mzotof/KR_MPS/README.md

**Курсовая работа по МПС "Электронная очередь"**

master.c - главный мастер

slave_user.c - прием сигналов от пользователей о прохождении

slave_admin.c - прием сигналов от админа о вызове пользователя
