mzotof/KR_MPS/РПЗ.pdf

Реферат

Расчетно-пояснительная записка страниц 33, рисунков 17, таблиц 5, ис-

точников 10, приложений 4.

Ключевые слова: МИКРОКОНТРОЛЛЕР, ATMEGA32, ЭЛЕКТРОННАЯ

ОЧЕРЕДЬ, СЕТЬ, RS-485, АППАРАТАНАЯ СИСТЕМА.

Объектом разработки данной курсовой работы является проект аппарат-

ная система «Электронная очередь», предназначенная для организации элек-

тронной очереди, в которой участвуют пользователи, администраторы и

устройства, отображающие состояние очереди.

Целью разработки являлось проектирование функционально законченной

системы, построенной на микроконтроллерах, удовлетворяющей заданным

техническим заданием требованиям, и разработка необходимой конструктор-

ской и технической документации на проектируемую систему. При проектиро-

вании были решены следующие задачи: анализ объекта разработки на функци-

ональном уровне, разработка функциональной схемы системы, выбор элемент-

ной базы для реализации объекта, расчет электрических параметров.

В ходе работы разработаны алгоритмы функционирования системы,

функциональная и электрическая принципиальная схемы, написаны коды

функционирования, соответствующие разработанным алгоритмам.

Для написания кодов был использован язык СИ AVR, работа осуществ-

лялась в среде WinAVR. Для проверки работоспособности разработанная схема

была промоделирована в среде Proteus ISIS 8.

Результатом проектирования является комплект конструкторской доку-

ментации для изготовления аппаратной системы «Электронная очередь» и мо-

дель этой системы.

ОПРЕДЕЛЕНИЯ, ОБОЗНАЧЕНИЯ И СОКРАЩЕНИЯ

АСЭО – аппаратная система «Электронная очередь»,

МК – микроконтроллер,

ИМС – интегральные микросхемы.

Содержание

Введение

Настоящий курсовой проект распространяется на разработку аппаратной

системы «Электронная очередь» (АСЭО), предназначенной для организации

электронной очереди, в которой участвуют пользователи, администраторы и

устройства, отображающие состояние очереди.

Задача организации электронной очереди является актуальной во многих

областях, связанных с обслуживанием клиентов. Хорошо организованная элек-

тронная очередь позволяет уменьшить загруженность потока клиентов и время

ожидания в очереди.

Разработка устройства состоит из трех основных частей:

− аппаратной части – принципа взаимодействия микроконтроллеров (МК),

средств отображения информации – дисплеев, и средств ввода – кнопок;

− программной части – написание программ для МК;

− технологической части – тестирование системы посредством симуляции в

среде Proteus ISIS 8.

Во время выполнения курсовой работы необходимо построить функцио-

нальную и принципиальную схемы, разработать алгоритмы работы системы, на

основе которых программируется МК, а также рассчитать потребляемую мощ-

ность.

### 1 Анализ требований

Система должна состоять как минимум из трех модулей:

1) модуль приема сигналов от пользователей об их желании встать в оче-

редь;

2) модуль приема сигналов от администратора о готовности принять перво-

го в очереди клиента;

3) модуль отображения состояния очереди.

Полученное задание можно решить при помощи системы, состоящей из

следующих крупных элементов:

1) МК, связанный с дисплеем, отображающим номер нового клиента в оче-

реди, и кнопкой, принимающей сигналы от пользователей;

2) МК, связанный с дисплеем, отображающим номер первого в очереди кли-

ента, и кнопкой, принимающей сигналы от администратора;

3) МК, связанный с дисплеем, отображающем состояние очереди.

МК должны быть связаны между собой, чтобы обмениваться информа-

ций. По заданию связь МК должна быть организована с помощью интерфейса

по стандарту RS-485.

Для определенности положим, что в очереди может быть не более 99 кли-

ентов: от 1 до 99. Соответственно, для вывода номера клиента, потребуется 2-

разрядные дисплеи.

### 2 Проектирование функциональной схемы системы

По заданию необходимо использовать МК семейства AVR. Для реализа-

ции проектируемой системы был выбран МК ATMega32, имеющий память

SRAM 2Кб и Flash 32Кб.

МК, отражающий текущее состояние очереди, должен выводить очередь

на дисплей. Для определенности будем использовать два 2-разрядных дисплея,

чтобы выводить номера первого и второго пользователей в очереди. Выводить

информацию на дисплеи будем по параллельной шине. Дисплеи выберем 7-

сегментные, соответственно, ширина шины будет равна 7. Также, для каждого

дисплея необходимы 2 управляющих сигнала, определяющих на какой разряд

выводить информацию с шины. Для первого дисплея забронируем 7 пинов пор-

та А, для второго 7 пинов порта В, управляющие сигналы будем подавать с 4

пинов порта C.

МК, принимающие сигналы от пользователей и администраторов, долж-

ны выводить номер нового пользователя или номер следующего пользователя и

принимать сигналы от пользователей или от администратора, для чего необхо-

димы кнопки. Для вывода номера пользователя будем использовать аналогич-

ные дисплеям МК, отражающего очередь, дисплеи. Забронируем под них 7 пи-

нов порта А, а под управляющие сигналы забронируем 2 пина порта В. Прини-

мать сигналы от кнопок будем с помощью 3-его пина порта В.

Так как все три МК должны посылать друг другу информацию и прини-

мать информацию друг от друга, необходимо задействовать протокол UART на

всех МК, что обязывает забронировать 0 и 1 пины порта D под использование

UART: 0 пин порта D – RX (прием данных), 1 пин порта D – TX (отправка дан-

ных).

При подключении RX и ТХ одного МК к ТХ и RX двух других МК полу-

чается ситуация, при которой RX второго МК подключен к RX третьего МК, с

выходами TX аналогично. Такая ситуация создает ошибку работы UART, что

обязывает к организации более сложной системы приема и передачи данных.

Необходимо использовать приемо-передатчик MAX485, который способен переключать в режим передачи или приема в зависимости от управляющих сиг-

налов TE (разрешение передачи) и RE (разрешение приема) и преобразует ТТЛ

сигналы в сигналы по стандарту RS-485. Таким образом на участке с сигналами

RS-485 будет присутствовать информация, отправленная одним из МК и будет

приниматься двумя другими МК. Для организации управляющих сигналов

TE/RE задействуем 3 пин порта D на всех МК.

Разработанная функциональная схема представлена в приложении А.

### 3 Проектирование принципиальной схемы устройства

### 3.1 Выбор и реализация разъемов

Выбранная реализация принципиальной схемы устройства подразумевает

наличие 5 разъемов:

− разъем (вилка XP1 и розетка XS1), отвечающий за соединение с источни-

ком питания;

− разъем (вилка XP2 и розетка XS2), отвечающий за соединение модуля A1,

отображающего состояние очереди, и модуля A2, принимающего сигна-

лы от пользователей;

− разъем (вилка XP3 и розетка XS1), отвечающий за соединение модуля A2,

принимающего сигналы от пользователей, и модуля A1, отображающего

состояние очереди;

− разъем (вилка XP4 и розетка XS2), отвечающий за соединение модуля A2,

принимающего сигналы от пользователей, и модуля A3, принимающего

сигналы от администратора;

− разъем (вилка XP5 и розетка XS1), отвечающий за соединение модуля A3,

принимающего сигналы от администратора, и модуля A2, принимающего

сигналы от пользователей.

Соединение с источником питания предполагает 2 контакта: питание си-

стемы +5 В и 0 В GND. Для реализации данного разъема выберем разъем типа

DE-9 семейства D-sub.

Соединения между модулями, предполагает 4 контакта: прямой сигнал A

и инвертированный сигнал B по стандарту RS-485, питание системы +5 В и 0 В

GND. Для реализации данного разъема также выберем разъемы типа DE-9 се-

мейства D-sub.

Для всех разъемов выбраны разъемы из семейства D-sub. Разъемы семей-

ства D-sub содержат два или более параллельных рядов штырьковых контактов

или контактных гнёзд, обычно окружённых металлическим экраном в форме

латинской буквы «D», который обеспечивает механическое крепление соединения, предохраняет от неправильной ориентации при подключении и экранирует

от электромагнитных помех. Для крепления на плату на внутренней части разъ-

емов имеются цилиндрические контакты, которые непосредственно впаиваются

в плату. Фиксация разъема на плате осуществляется с помощью специальных

фиксаторов: гайки с винтом [1]. Характеристики разъема представлены на ри-

сунке 1.

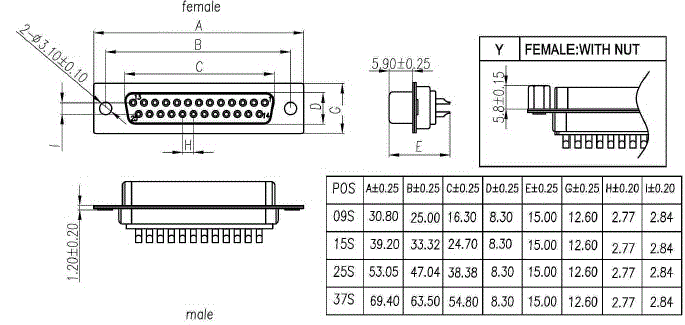
[picture p1: figure]

Рисунок 1 – Характеристики разъемов семейства D-sub

Соответствия между контактами разъемов и контактов схемы разрабаты-

ваемого устройства для разъема XP1-XS1 приведены в таблице 1, для разъемов

XP2-XS2, XP3-XS1, XP4-XS2 и XP5-XS1 в таблице 2.

Таблица 1 – Подключение контактов к разъему XP1-XS1

Номер контакта в разъеме | Назначение контакта | Обозначение
1 | Питание системы +5В | VCC
2..9 | 0 В | GND

Таблица 2 – Подключение контактов к разъемам XP2-XS2, XP3-XS1, XP4-XS2

и XP5-XS1

Номер контакта в разъеме | Назначение контакта | Обозначение
1 | Инвертированный сигнал по стандарту RS-485 | B
2 | Прямой сигнал по стандарту RS-485 | A
3 | Питание системы +5В | VCC
4..9 | 0 В | GND

### 3.2 Выбор конденсаторов для питания микросхем

Для устранения ВЧ-помех при использовании интегральных микросхем

(ИМС) применяют шунтирующие конденсаторы небольшой емкости, подклю-

ченные к входу, питающему ИМС. Для шунтирования ИМС был выбран кера-

мический конденсатор емкостью 100 нФ GRM188R71C104KA01D.

### 3.3 Реализация высокочастотного генератора импульсов

Для реализации высокочастотного генератора импульсов использован

кварцевый резонатор 8MHz HC-49US. Схема его подключения показана на ри-

сунке 2.

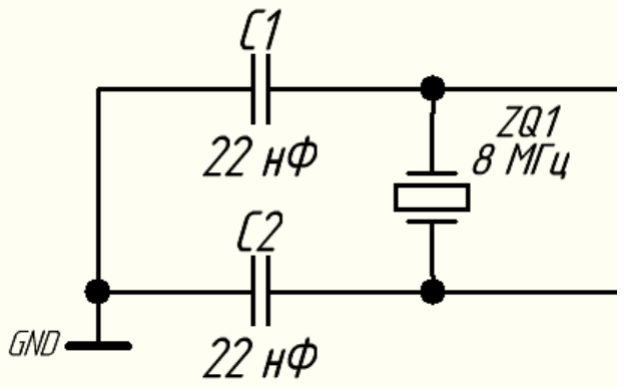
[picture p2: figure]

Рисунок 2 – Схема подключения кварцевого резонатора

Используемые в этой схеме конденсаторы – GRM21B5C1H223JA01L.

### 3.4 Реализация дисплеев

В устройствах использованы дисплеи BL-D56X-22 – 2-разрядные 7-

сегментные дисплеи с управляющими сигналами для выбора разряда, на который будет транслироваться информация с информационных входов. Схема

подключения светодиодов в дисплее представлена на рисунке 3.

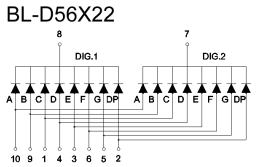
[picture p3: figure]

Рисунок 3 – Схема подключения светодиодов в дисплее

Для вывода информации используются информационные входы A, B, C,

D, E, F, G, DP (пины 10, 9, 1, 4, 3, 6, 5 и 2 соответственно). Для выбора разряда

используются входы D1 и D2 [2]. На информационные входы подадим сигналы

от МК, кроме входа DP, который использовать не будем. На входы D1 и D2 по-

дадим управляющие сигналы от МК.

Для контроля силы тока в I = 20мА в цепи МК-светодиод-МК установим

ИМС ULN2003, являющуюся матрицей инверторов с открытым коллектором

[3], резисторы SMD 0805 100 Ом+-5% и полевые транзисторы FDN306P. Вы-

браны резисторы на R = 100 Ом, так как падение напряжения на одном инвер-

торе Ui = 1В [3], на одном светодиоде Ud = 1,85В [2], на одном полевом транзи-

сторе Ut = 0,2В:

R =

U − (Ui + Ud + Ut)
I

=

5 − (1 + 1,85 + 0,2)
20 ∗ 10⁻³ = 100 Ом

Дисплей выглядит так, как показано на рисунке 4. В таблице 2 приведено

соответствие отображаемой цифры сигналам на информационных входах. В

таблице 3 приведено соответствие комбинаций управляющих сигналов состоя-

ниям дисплея.

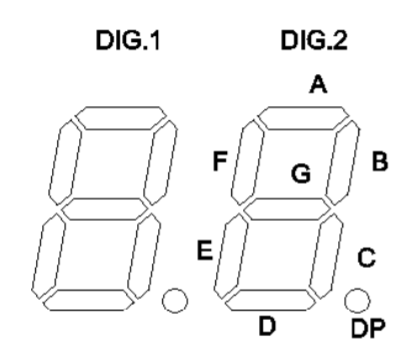
[picture p4: figure]

Рисунок 4 – Дисплей

Таблица 2 – Соответствие цифр сигналам на информационных входах дисплея

Цифра | Сигналы на входах (A,B,C,D,E,F,G соответственно)
0 | 00111111
1 | 00000110
2 | 01011011
3 | 01001111
4 | 01100110
5 | 01101101
6 | 01111101
7 | 00000111
8 | 01111111
9 | 01101111

Таблица 3 – Соответствие управляющих сигналов состояниям дисплея

D1 | D2 | Состояние дисплея
0 | 0 | Горят оба разряда
0 | 1 | Горит первый разряд
1 | 0 | Горит второй разряд
1 | 1 | Оба разряда не горят

### 3.5 Организация ввода информации

Для получения сигналов от пользователей и администратора необходимы

кнопки. Будем использовать кнопки 1-1437565-6 (FSM1LP). На один контакт

кнопки подадим 0В, а другой контакт свяжем с МК.

### 3.6 Подключение микроконтроллеров

Схема МК ATMega32 представлена на рисунке 5 [4]. Подключение МК

выполним в соответствие с функциональной схемой системы. Также подадим

на входы VCC и AVCC (пины 10 и 30 соответственно) 5В, а на входы GND

(пины 11 и 31) 0В. Ко входам XTAL1 и XTAL2 (пины 13 и 12) подадим сигналы от высокочастотного генератора сигналов. Ко входу R̅ (сброс) подключим

сигнал RESET из разъема XS2, предварительно установив подтягивающий ре-

зистор R1 на 10 кОм и параллельно к нему конденсатор C5 на 100 нФ. На сво-

бодные входы подадим 0В.

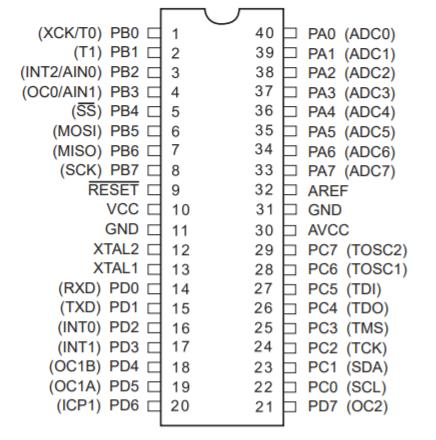
[picture p5: figure]

Рисунок 5 – Микроконтроллер ATMega32

### 3.7 Организация обмена данными между микроконтроллерами

Как уже было решено на этапе проектирования функциональной схемы

системы, для обмена данными будут использоваться ИМС MAX485. Схема

данной ИМС представлена на рисунке 6.

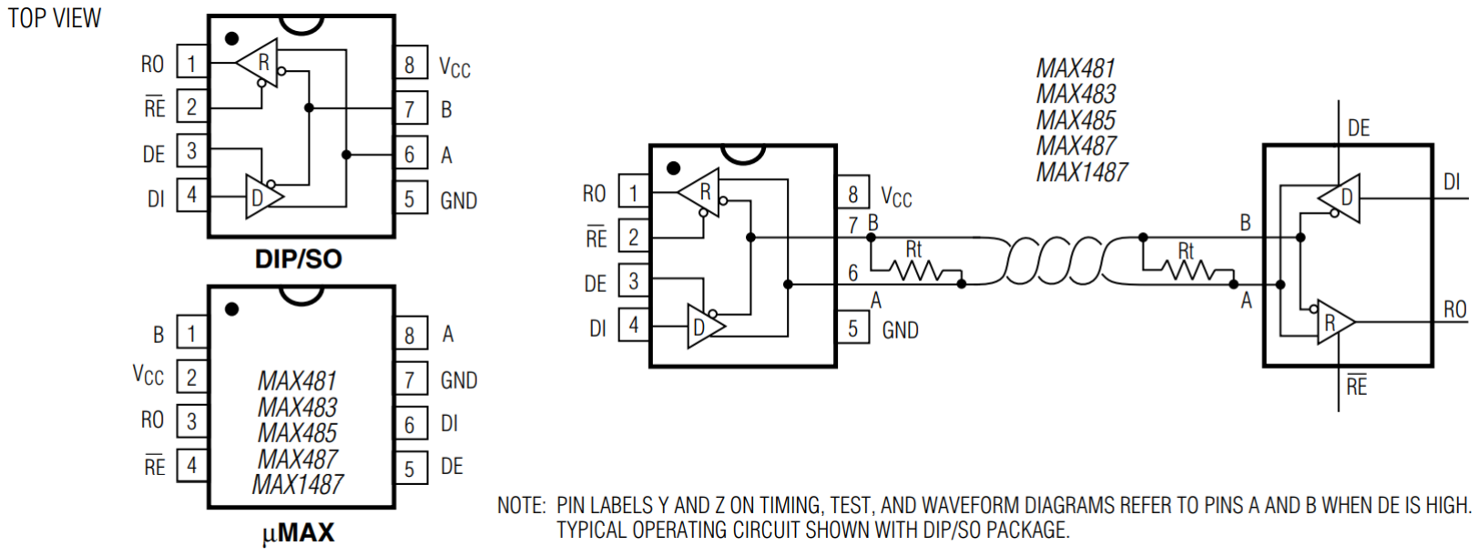
[picture p6: figure]

Рисунок 6 – ИМС MAX485

Данная ИМС может работать в двух режимах: приемник и передатчик. Выбор режима осуществляется с помощью входов RE̅̅ (receiver enable) и DE

(driver enable). Входы A и B – входы/выходы сигнала по стандарту RS-485. Вы-

ход RO (receiver output) – выход приемника – преобразованный ТТЛ-

совместимый сигнал. Вход DI (driver input) – вход передатчика. VCC – питание,

GND – 0 В [5].
К входам RE̅̅ и DE подключим PD2 МК, к RO подключим PD0 (RX

UART), к DI подключим PD1 (TX UART). Входы/выходы A и B подключим к

разъемам XS1.

На выходах разъемов XP1, XP2 и XP3 имеем сигналы по стандарту RS-

485. Соединим эти разъемы. Во избежание отражения сигнала от конца длин-

ной линии – провода с сигналом по стандарту RS-485, подключим в конце цепи

резистор R8 на 120 Ом.

Такая организация обмена данными между МК позволяет расширять си-

стему добавляя в нее новые модули.

### 3.8 Реализация принципиальной схемы и перечня элементов

В соответствие с выявленными требованиями была реализована принци-

пиальная схема системы, представленная в приложении Б. К принципиальной

схеме был составлен перечень используемых элементов, представленный в

приложении В.

### 4 Расчет потребляемой мощности

Все ИМС питаются от напряжения VCC +5 В. Для оценки потребляемой

мощности применим формулу:
P = Uп ∗ Iпотр

Uп — напряжение питания, Iпотр — ток, потребляемый ИМС или диодом.

Цепь МК-светодиод-МК работает при напряжении 5В и силе тока 20мА.

Рассчитаем статическую мощность, потребляемую спроектированной си-

стемой, и проведем расчеты в таблице 4 [2, 3, 4, 5, 8].

Таблица 4 – Расчет потребляемой мощности

Элемент | Количество | Iпотр, мА | P, мВт
ATMega32 | 3 | 15 | 225
MAX485 | 3 | 0.9 | 13.5
ADM707 | 3 | 0.25 | 3.75
МК-диод-МК | 4 | 20 | 400
Итого: | | | 642.25

Таким образом, суммарная потребляемая мощность равна 642.25 мВт.

### 4.1 Организация питания системы

Для предотвращения поломки устройства при скачках напряжения уста-

новим самовосстанавливающийся предохранитель и стабилитрон у разъема,

питающего устройство. Ток в цепи равен полной потребляемой мощности, де-

леной на напряжение в цепи:

I =

P
Uп

=

642.25 мВт
5 В

= 128.45 мА

Учитывая, что ток в цепи равен 128.45 мА, был установлен самовосста-

навливающийся предохранитель MF-MSMF020 на 200 мА и стабилитрон

1N5339BRLG. При силе тока более 200 мА предохранитель сработает, что при-

ведет к прекращению протекания тока через цепь. При напряжении более 7 В

стабилитрон будет пропускать через себя большой ток на общую точку 0 В, что

спровоцирует срабатывание предохранителя менее, чем за 10 секунд [6, 7].

Также была установлена ИМС ADM707 для генерации сигнала запуска устройства. Входы данной ИМС: MR ̅̅ (вход для подключения кнопки сброса

устройства), PFI (вход проверки питания), VCC (питание), GND (0 В). Выходы данной ИМС: RESET (сигнал включения устройства), RESET ̅̅̅̅̅̅̅̅̅ (инвертирован-

ный сигнал запуска устройства), PFO ̅̅̅̅̅ (выход проверки питания). На рисунке 7

показана схема данной ИМС [8].

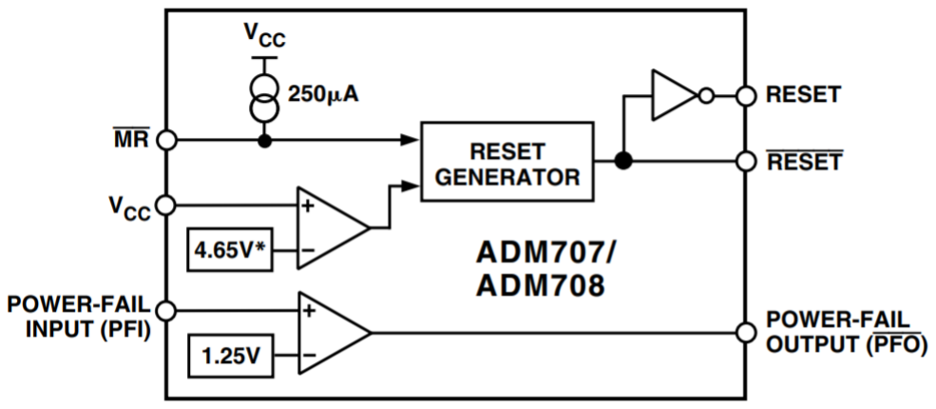
[picture p7: figure]

Рисунок 7 – Схема ИМС ADM707 На входы PFI и выход PFO ̅̅̅̅̅ подадим 0 В, так как не будем пользоваться

функцией проверки питания. На вход MR ̅̅ также подадим 0 В, так как кнопка

сброса не предусмотрена. Выход RESET соединим с общей точкой 0 В, так как

не будем его использовать. Питание подадим на вход VCC, подадим 0 В на вход GND и подключим вход RESET ̅̅̅̅̅̅̅̅̅ к МК.

### 5 Разработка программ для микроконтроллеров

При выбранной конфигурации системы необходимо организовать взаи-

модействие МК следующим образом: главный МК с некоторой периодично-

стью посылает запросы данных двум другим МК, а они отвечают на данные за-

просы. Такой подход необходим по причине того, что, если каждый МК будет

инициировать посылку данных может возникнуть ситуация, что на участке це-

пи RS-485 окажется два пакета полезных данных, которые исказят друг друга, и

полезная информация не дойдет до ее приемника.

Выберем в качестве главного микроконтроллера микроконтроллер, отве-

чающий за отображение состояния очереди. Его удобно выбрать, так как ему

необходимо взаимодействовать с двумя другими ведомыми МК, а им между

собой взаимодействовать необязательно.

Также необходимо разработать схему взаимодействия МК, при которой

ведомые будут распознавать определенный запрос от ведущего и отвечать

только на такие запросы, другие запросы должны игнорироваться, в том числе

и те пакеты данных, которые отправляет другой ведомый, ведь ведомые будут

переключаться в режим передатчика только в тех случаях, когда им необходи-

мо отправить данные, в остальных случаях они будут принимать все отправ-

ленные данные.

Для распознавания ведомыми кому из них предназначен отправленный

ведущим запрос зарезервируем один из битов в пакете данных под флаг при-

надлежности ведомым. Пусть этот бит будет равен 0, если запрос предназначен

для МК, принимающего сигналы от администратора, и равен 1, если запрос

предназначен для МК, принимающего сигналы от пользователей. Аналогично и

с ответом ведущему от ведомых: если флаг равен 0, то этот ответ от МК, при-

нимающего сигналы от администратора, и 1, если это ответ от МК, принимаю-

щего сигналы от пользователей.

Полезные данные в пакете будут представлять из себя номер нового

пользователя либо пользователя, следующего в очереди. Номер пользователя принимает значения от 1 до 99, соответственно нам будет достаточно 2⁷=128 уникальных значений, для идентифицирования пользователя, то есть под по-

лезные данные выделим 7 бит в пакете.

Таким образом размер пакета данных равен 8 бит и представляет из себя

последовательность, описанную в таблице 5.

Таблица 5 – Пакет данных, отправляемый МК

Номер бита | 7 | 6 | 5 | 4 | 3 | 2 | 1 | 0
Значение | Флаг принадлежности ведомым | Полезная информация

Разобравшись с архитектурой взаимодействия МК, была разработана

схема взаимодействия МК, представленная на рисунке 8.

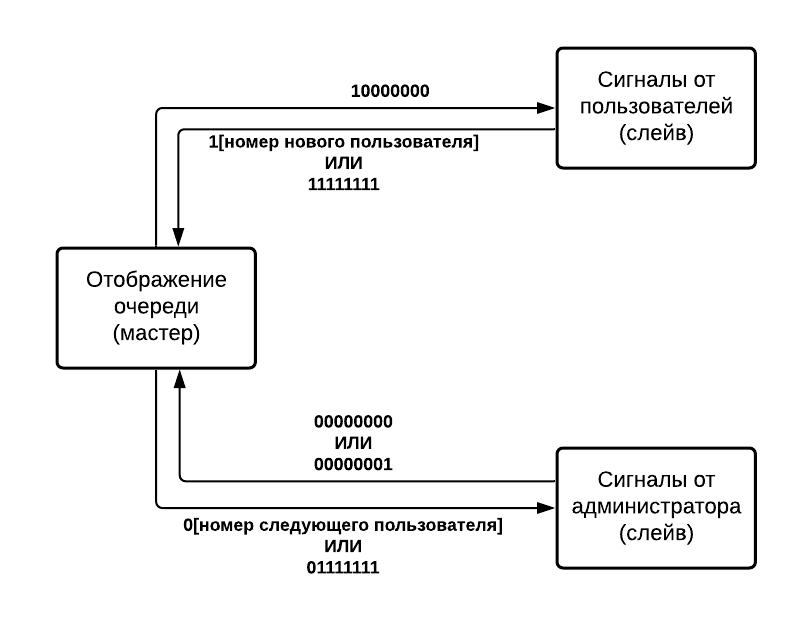
[picture p8: figure]

Рисунок 8 – Схема взаимодействия МК

Общение ведущего с ведомым, принимающим сигналы от пользователей:

1) ведущий отсылает запрос данных – 10000000;
2) ведомый отвечает номером нового пользователя в очереди (с флагом

принадлежности 1), если таковой появился, либо пакетом 11111111, если

новый пользователь еще не пришел.

Общение ведущего с ведомым, принимающим сигналы от администрато-

ра:

1) ведущий посылает запрос данных в виде номера следующего в очереди

пользователя (с флагом принадлежности 0), если очередь не пуста, либо

пакетом 01111111, если очередь пуста;

2) ведомый отвечает пакетом 00000000, если администратор еще не вызвал

нового пользователя и 1 – в обратном случае.

Для программирования МК были использованы следующие источники:

− Хартов В.Я. – Микропроцессорные системы [9];

− электронный ресурс – Программирование МК AVR [10].

### 5.1 Разработка программы для ведущего микроконтроллера

### 5.1.1 Инициализация

Ведущий МК отображает состояние очереди, а значит необходимо вклю-

чить вывод на 7 пинах портов А и В и на 4 пинах порта С, в соответствие с

принципиальной схемой (приложение Б).

На 2 и 1 пинах порта D необходимо включить вывод для управляющего

сигнала MAX485 и TX UART соответственно.

На пинах 2 и 0 порта D необходимо включить подтягивающие резисторы

для управляющего сигнала MAX485 и RX UART соответственно.

UART необходимо настроить так:

− включить скорость передачи BAUD = 9600 Бод (это повысит надежность

передачи данных) при тактовой частоте работы МК равной fclk = 8МГц:

UBRR =

fclk
16∗BAUD

− 1 =

8000000
16∗9600

− 1 ≈ 51 – содержимое регистра контрол-

лера скорости передачи;

− разрешить прием и передачу данных в регистре UCSRB;

− установить бит URSEL регистра UCSRC в 1;

− включить 8-битные посылки данных (UCSZ1 = 1 и UCSZ0 = 1).

### 5.1.2 Глобальные переменные

Будут использоваться следующие глобальные переменные:

− queue – массив с номерами пользователей в очереди;

− qlen – длина очереди;

− digits – соответствие цифр и занчений на информационных входах дис-

плея (в соответствие с таблицей 1).

### 5.1.3 Код программы

Была разработана программа работы ведущего МК, представленная в

приложении Г на листинге 1. Обобщенная схема алгоритма представлена на ри-

сунке 9.

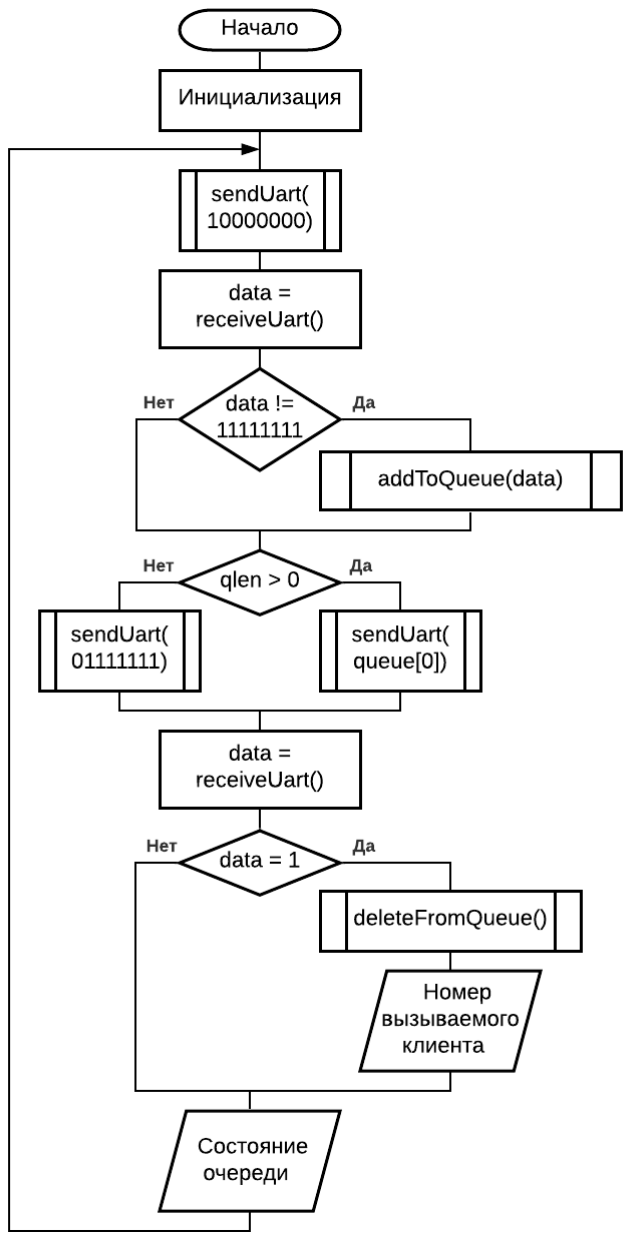
[picture p9: figure]

Рисунок 9 – Обобщенная схема алгоритма работы ведущего МК

Были разработаны подпрограммы:

− sendUart – отправка пакета данных по UART;

− recieveUart – получение данных по UART;

− addToQueue – добавление пользователя в очередь;

− goToMK2 – общение с МК, принимающем сигналы от пользователей;

− deleteFromQueue – удаление пользователя из очереди;

− goToMK3 – общение с МК, принимающим сигналы от администратора;

− outputQueue – вывод состояния очереди на дисплеи.

### 5.2 Разработка программы для 1-го ведомого микроконтроллера

### 5.2.1 Инициализация

Этот ведомый МК принимает сигналы от пользователей, а значит необхо-

димо включить вывод на 7 пинах порта А и на 2 пинах порта B и ввод на треть-

ем пине порта В, в соответствие с принципиальной схемой (приложение Б).

Порт D и UART должны быть настроены аналогично с ведущим МК, но

еще необходимо разрешить прерывания по приему UART (бит RXCIE регистра

UCSRB) и глобально разрешить прерывания.

### 5.2.2 Глобальные переменные

Будут использоваться следующие глобальные переменные:

− counter – количество новых клиентов;

− send – количество отправленных новых клиентов.

### 5.2.3 Код программы

Была разработана программа работы ведомого МК, принимающего сиг-

налы от пользователей, представленная в приложении Г на листинге 2. Обоб-

щенная схема алгоритма представлена на рисунке 10.

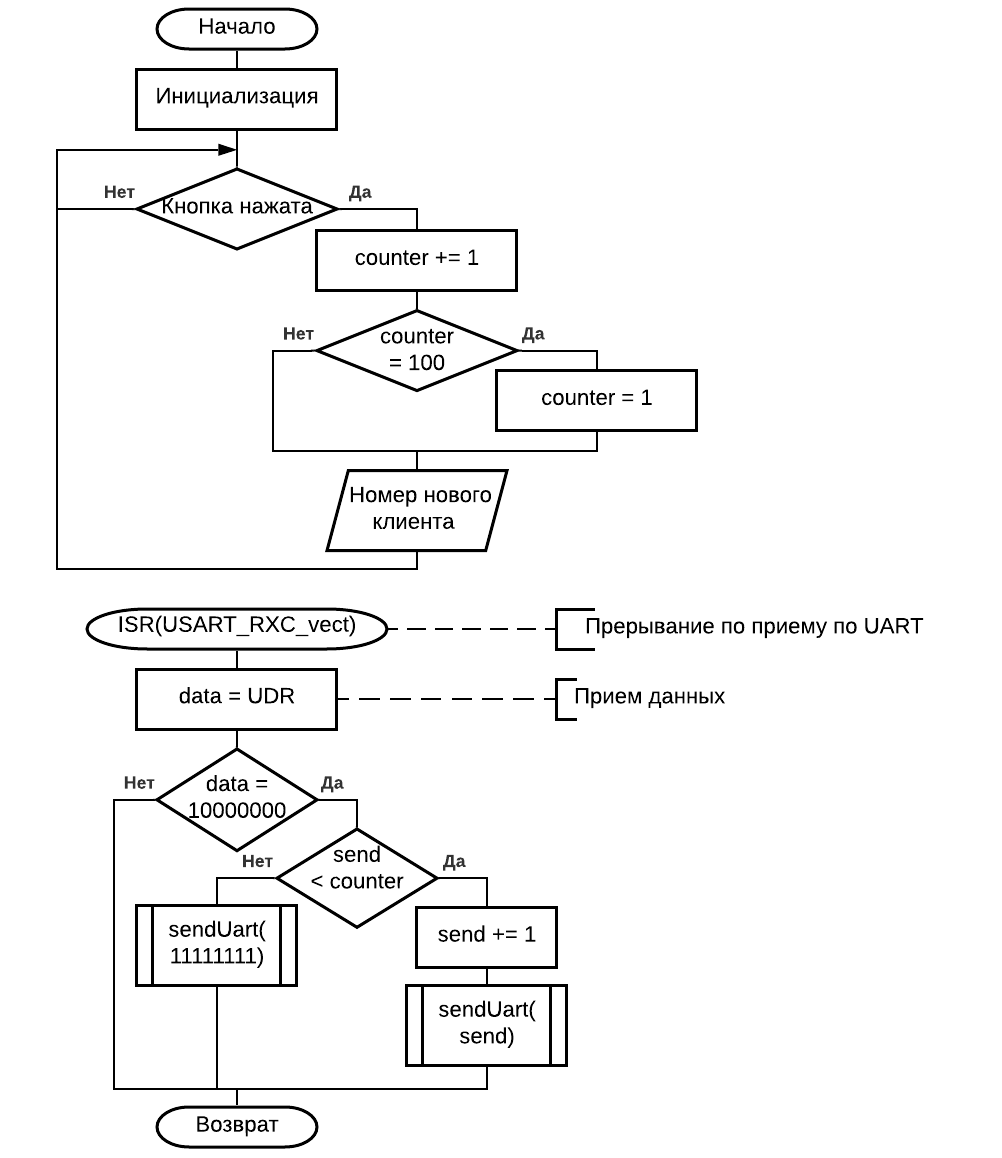
[picture p10: figure]

Рисунок 10 – Обобщенная схема алгоритма работы ведомого МК,

принимающего сигналы от пользователей

Были разработаны подпрограммы:

− sendUart – отправка пакета данных по UART;

− ISR(USART_RXC_vect) – прерывание по получению данных по UART;

− checkButton – проверка нажатия на кнопку.

### 5.3 Разработка программы для 2-ого ведомого микроконтроллера

### 5.3.1 Инициализация

Этот ведомый МК принимает сигналы от администратора. Он должен

быть настроен аналогично с ведомым МК, принимающем сигналы от пользова-

телей, в соответствие с принципиальной схемой (приложение Б).

### 5.3.2 Глобальные переменные

Будут использоваться следующие глобальные переменные:

− pressed – флаг нажатия на кнопку;

− emptyQueue – флаг пустоты очереди.

### 5.3.3 Код программы

Была разработана программа работы ведомого МК, принимающего сиг-

налы от администратора, представленная в приложении Г на листинге 3. Обоб-

щенная схема алгоритма представлена на рисунке 11.

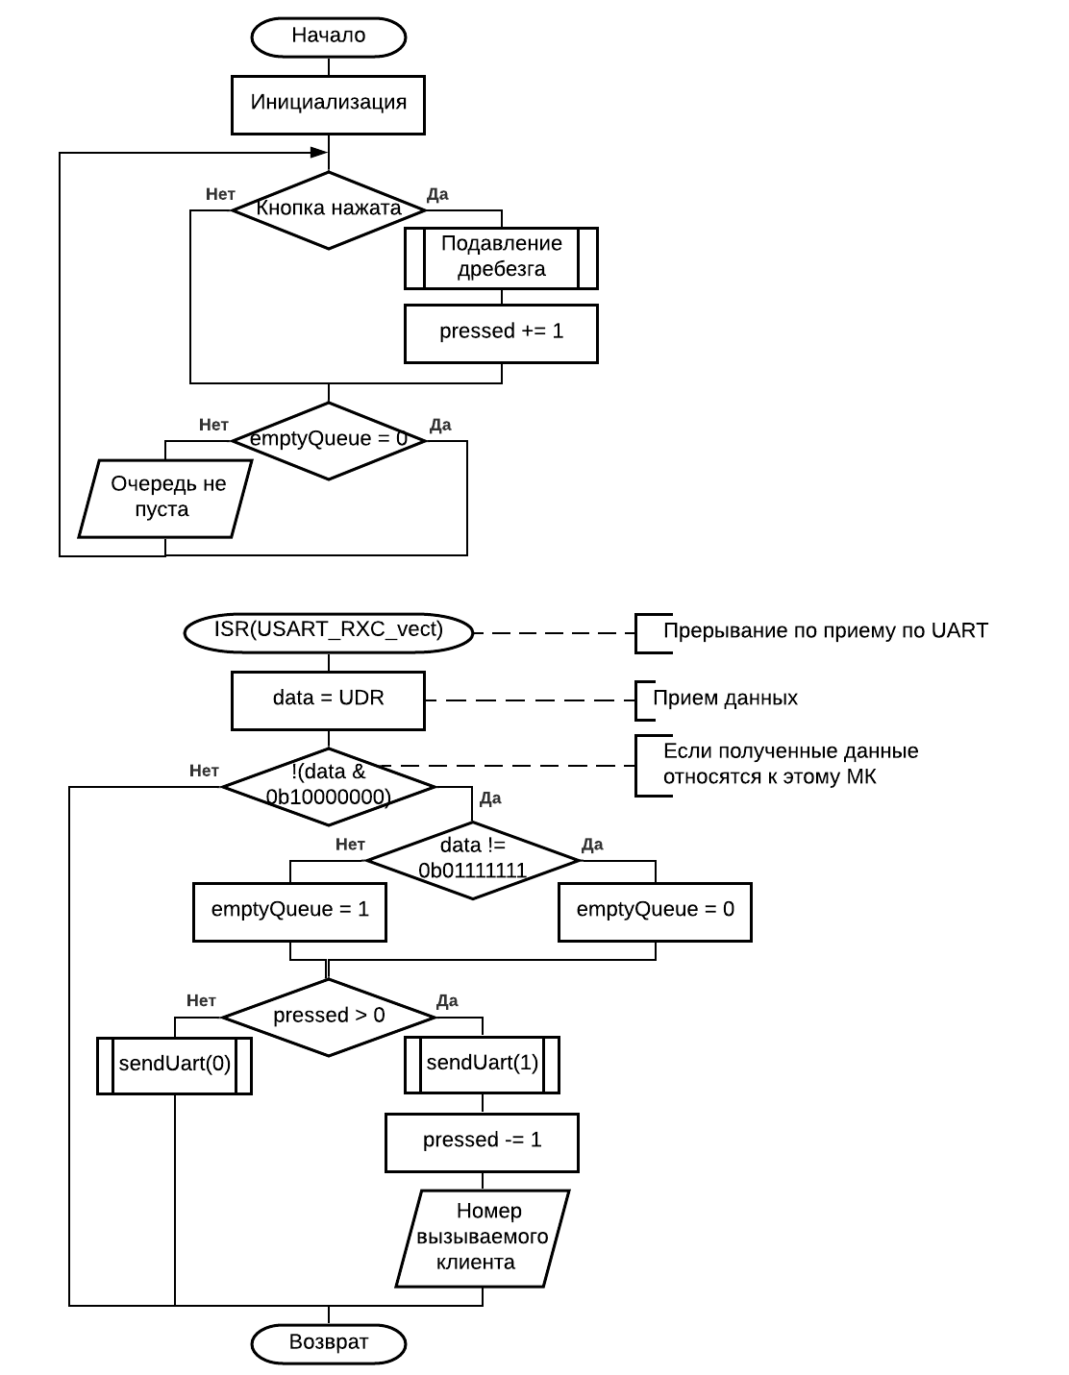
[picture p11: figure]

Рисунок 11 – Обобщенная схема алгоритма работы ведомого МК,

принимающего сигналы от администратора

Были разработаны подпрограммы:

− sendUart – отправка пакета данных по UART;

− ISR(USART_RXC_vect) – прерывание по получению данных по UART;

− checkButton – проверка нажатия на кнопку;

− outputNotEmptyQueue – вывод сигнала о том, что очередь не пуста.

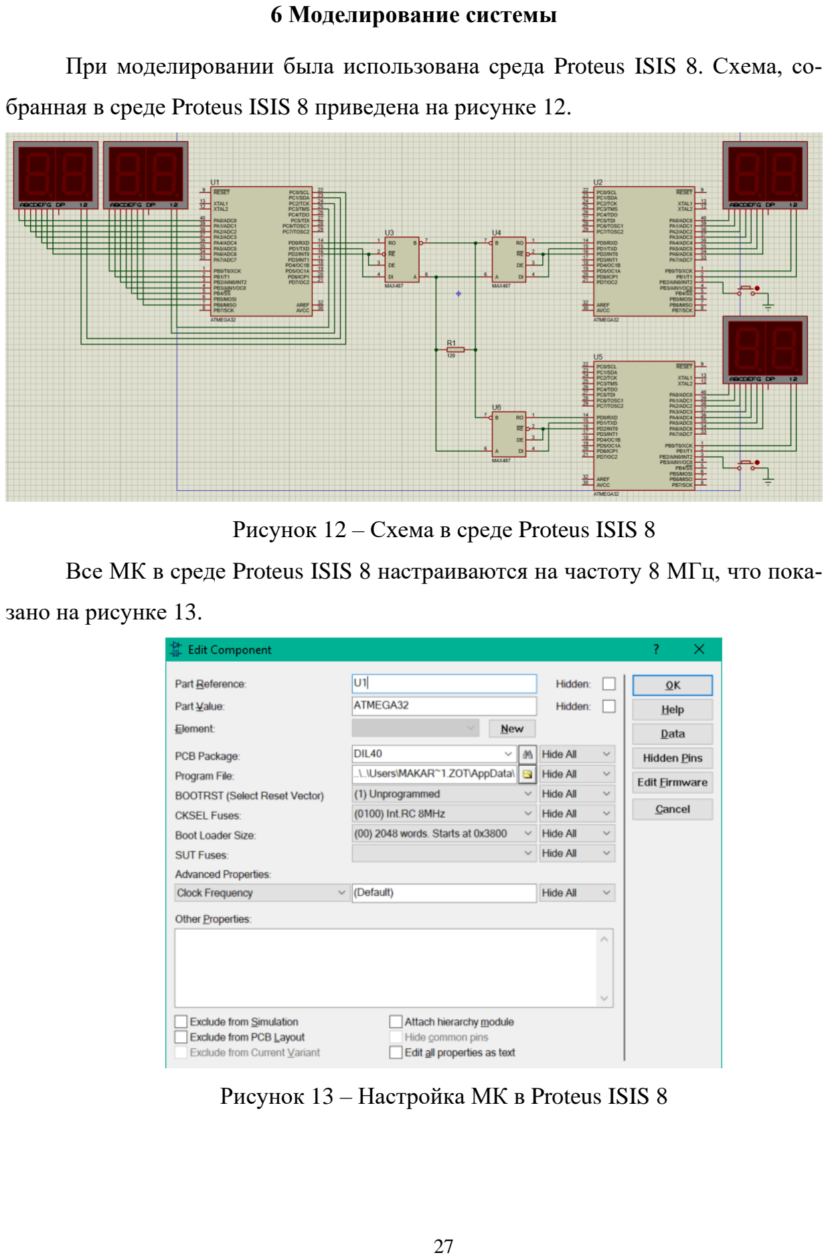
[picture p12: page 27]

### 6 Моделирование системы

При моделировании была использована среда Proteus ISIS 8. Схема, со-

бранная в среде Proteus ISIS 8 приведена на рисунке 12.

Рисунок 12 – Схема в среде Proteus ISIS 8

Все МК в среде Proteus ISIS 8 настраиваются на частоту 8 МГц, что пока-

зано на рисунке 13.

Рисунок 13 – Настройка МК в Proteus ISIS 8

### 7 Тестирование системы

При запуске симуляции в среде Proteus ISIS 8 дисплеи ничего не отобра-

жают (рисунок 12).

Протестируем обе функции системы:

1) добавление пользователя в очередь посредством нажатия на кнопку, по-

дающую сигнал о добавлении нового пользователя в очередь;

2) удаление пользователя из очереди посредством нажатия на кнопку, по-

дающую сигнал о вызове пользователя администратором.

### 7.1 Добавление пользователя в очередь

При нажатии на кнопку, подающую сигнал о добавлении нового клиента

в очередь, номер этого пользователя (№1) мигает на дисплее, подключенном к

МК, принимающем сигналы от пользователей, и появляется на первом дисплее,

отображающем состояние очереди, а также на дисплее, подключенном к МК,

принимающем сигналы от администратора, появляется сигнал о том, что оче-

редь не пуста. При повторном нажатии происходит аналогичная ситуация,

только номер этого пользователя (№2) появляется на втором дисплее, отобра-

жающем состояние очереди (рисунок 14).

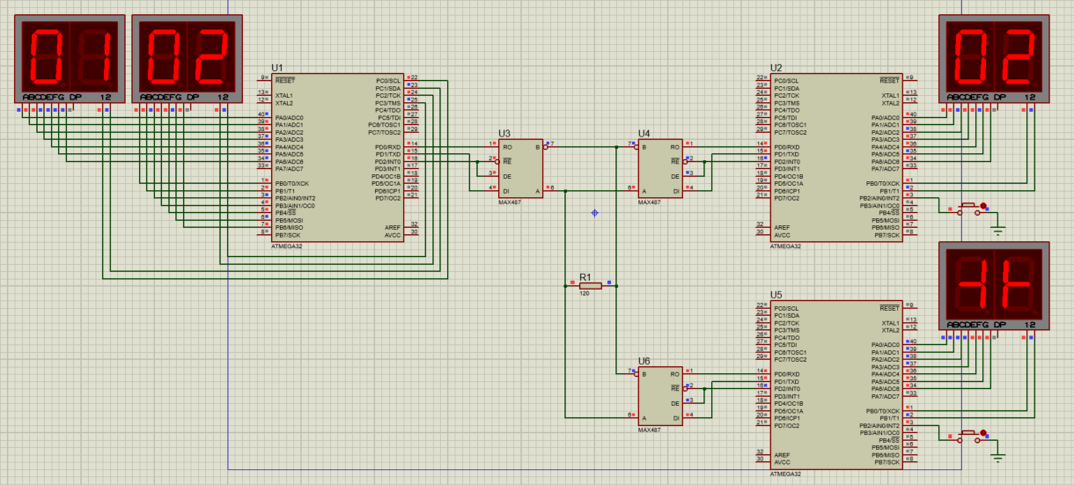
[picture p13: figure]

Рисунок 14 – Добавление пользователя в очередь

Оба пользователя успешно добавлены в очередь, администратор знает,

что очередь не пуста. Тест прошел успешно.

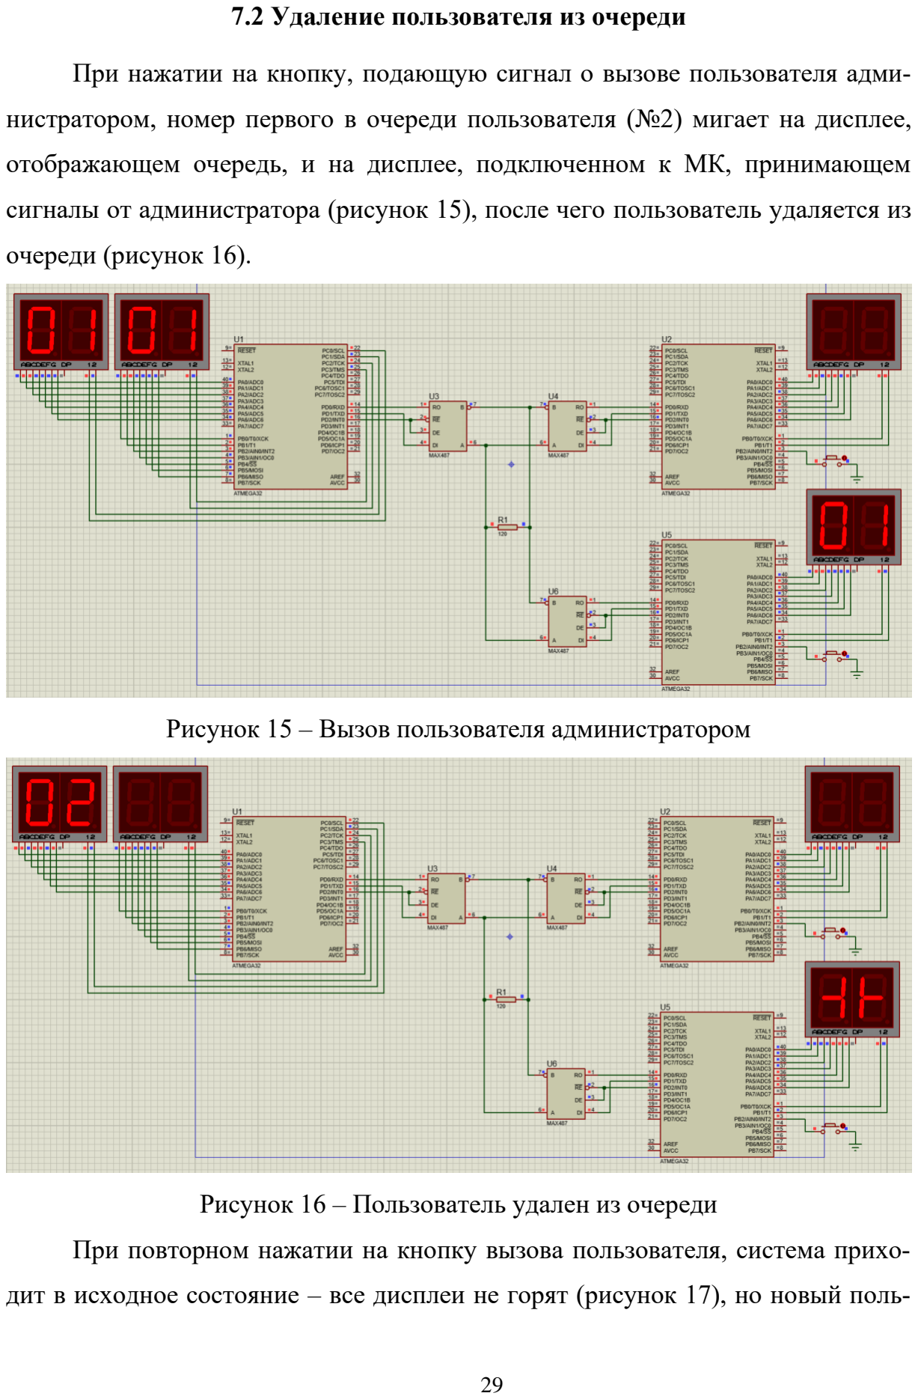
[picture p14: page 29]

### 7.2 Удаление пользователя из очереди

При нажатии на кнопку, подающую сигнал о вызове пользователя адми-

нистратором, номер первого в очереди пользователя (№2) мигает на дисплее,

отображающем очередь, и на дисплее, подключенном к МК, принимающем

сигналы от администратора (рисунок 15), после чего пользователь удаляется из

очереди (рисунок 16).

Рисунок 15 – Вызов пользователя администратором

Рисунок 16 – Пользователь удален из очереди

При повторном нажатии на кнопку вызова пользователя, система прихо-

дит в исходное состояние – все дисплеи не горят (рисунок 17), но новый пользователь в очереди получит номер 3. После 99 пользователя новому пользова-

телю выдается номер 1.

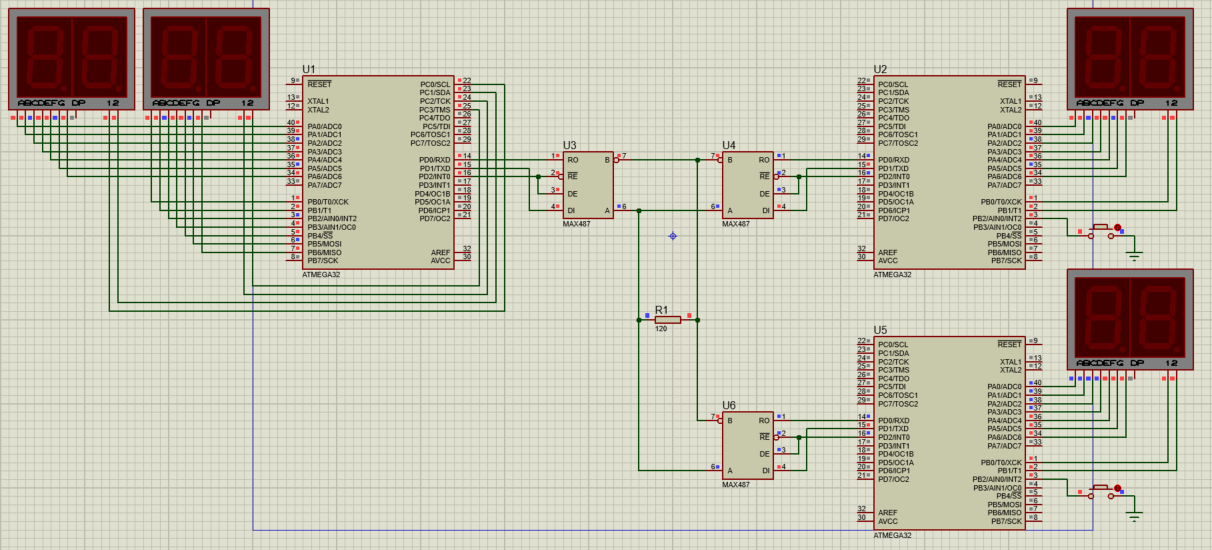
[picture p15: figure]

Рисунок 17 – Все пользователи удалены из очереди

Оба пользователя успешно удалены из очереди, администратор знает, что

очередь пуста. Тест прошел успешно.

Заключение

В ходе выполнения данной курсовой работы была разработана система,

предназначенная для организации электронной очереди, в которой участвуют

пользователи, администраторы и устройства, отображающие состояние очере-

ди.

Программный код системы был написан на языке Си процессоров семей-

ства AVR, для чего была использована среда разработки WinAVR. Было произ-

ведено моделирование системы в среде Proteus ISIS 8, и выполнена ее симуля-

ция.

Был подготовлен набор документации на объект разработки, состоящий

из расчетно-пояснительной записки, функциональной схемы, принципиальной

схемы, листинга программного кода, перечня элементов, использованных в си-

стеме.

Для развития разработанной системы может быть сделано большое коли-

чество доработок. Система легко расширяется: можно добавить в нее новые

модули, отображающие состояние очереди, модули, принимающие сигналы от

пользователей, или модули, принимающие сигналы от администратора. Также

несложно увеличить максимальное количество пользователей в очереди и мож-

но настроить МК на работу с более технологичными дисплеями.

Список литературы

1. D-sub [Электронный ресурс] URL: https://ru.wikipedia.org/wiki/D-sub (дата

обращения: 12.12.2021)

2. LED NUMERIC DISPLAY, 2 DIGIT BL-D56X-22 [Электронный ресурс]

URL: https://static.chipdip.ru/lib/258/DOC000258565.pdf (дата обращения:

12.12.2021)

3. ULN2001A, ULN2002A, ULN2003A, ULN2004A darlington transistor arrays
[Электронный | ресурс] | URL:
https://static.chipdip.ru/lib/042/DOC000042873.pdf | (дата | обращения:

12.12.2021)

4. ATmega32-16AU | Datasheet | [Электронный | ресурс] | URL:
https://static.chipdip.ru/lib/059/DOC000059770.pdf | (дата | обращения:

12.12.2021)

5. MAX481/MAX483/MAX485/MAX487–MAX491/MAX1487 | Datasheet

[Электронный ресурс] URL: http://www.farnell.com/datasheets/1700964.pdf

(дата обращения: 12.12.2021)

6. MF-MSMF Series - PTC Resettable Fuses [Электронный ресурс] URL:
https://static.chipdip.ru/lib/245/DOC000245515.pdf | (дата | обращения:

12.12.2021)

7. 1N53 | Series | [Электронный | ресурс] | URL:

https://eu.mouser.com/datasheet/2/308/1N5333B_D-2309169.pdf (дата обра-

щения: 12.12.2021)

8. ADM707 | Datasheet | [Электронный | ресурс] | URL:
https://static.chipdip.ru/lib/143/DOC000143996.pdf | (дата | обращения:

12.12.2021)

9. Микропроцессорные системы: учеб. пособие для студ. учреждений высш.

образования / В.Я. Хартов, – 2-е изд., испр. и доп. – М.: Издательский

центр «Академия», 2014, 368 с. – (Сер. Бакалавриат). – ISBN 978-5-4468-

0440-5;

10.Программирование | МК | AVR | [Электронный | ресурс] | URL:
https://narodstream.ru/programmirovanie-mk-avr/ | (дата | обращения:

12.12.2021)

Приложение А

Схема электрическая функциональная

Листов 1

Приложение Б

Схема электрическая принципиальная

Листов 1

Приложение В

Спецификация (перечень) используемых элементов

Листов 2

Приложение Г

Исходный код программ

Листинг 1 – Код программы МК, отображающего состояние очереди

#include <avr/io.h>

#include <util/delay.h>

volatile unsigned char queue[100], //очередь qlen = 0; // длина очереди const unsigned char digits[] = { 0b00111111, 0b00000110,
0b01011011,
0b01001111,
0b01100110,
0b01101101,
0b01111101,
0b00000111,
0b01111111,
0b01101111 }; // соответствие цифр и их обозначения на дисплее

void initUART(void) // инициализация UART
{
UBRRL=51; //скорость 9600 Бод при f=8 МГц UCSRB=(1<<RXEN)|(1<<TXEN); //разрешение приема и передачи UCSRC=(1<<URSEL)|(1<<UCSZ1)|(1<<UCSZ0); //8-битные посылки }

void sendUart(unsigned char c) // отправка по UART
{
PORTD |= (1<<PD2); // включение передачи
UDR = c;
while(!(UCSRA&(1<<UDRE))) {}; // ожидание опустошения UDR while(!(UCSRA&(1<<TXC))) {}; // ожидание отправки PORTD &= ~(1<<PD2); // включение приема
}

unsigned char recieveUart(void) // прием по UART
{
while(!(UCSRA&(1<<RXC))) {}; // ожидание приема PORTD |= (1<<PD2); // включение передачи return UDR;
}

void addToQueue(unsigned char a) // добавление пользователя в очередь {
queue[qlen] = a;
qlen++;
}

void goToMK2(void) // общение с МК2
{
sendUart(0b10000000);
unsigned char data = recieveUart(); if (data != 0b11111111)
addToQueue(data&0b01111111);
}

unsigned char deleteFromQueue(void) // удаление человека из очереди {
unsigned char rett = queue[0];
unsigned char i = 0;
while (queue[i] != 0)
{
queue[i] = queue[i+1];
i++;
}

qlen--;
return rett;
}

void goToMK3(void) // общение с МК3 {
unsigned char i, j, data;

if (qlen > 0) // если очередь не пуста
sendUart(queue[0]); // отправка номера следующего в очереди человека else
sendUart(0b01111111); // отправка сигнала, что очередь пуста

data = recieveUart();

if (data == 1)
{
unsigned char a = deleteFromQueue();
for (j = 0; j < 3; j++) // вывод вызываемого пользователя {
for (i = 0; i < 50; i++)
{
PORTC = 0b00001010;
PORTA = digits[a / 10];
PORTB = digits[a / 10];
_delay_ms(10);
PORTC = 0b00000101;
PORTA = digits[a % 10];
PORTB = digits[a % 10];
_delay_ms(10);
}
PORTC = 0b00001111;
_delay_ms(500);
}
}
}

void outputQueue(void) // вывод очереди {
if (qlen > 0)
{
if (qlen > 1)
{
PORTC = 0b00001010;
PORTA = digits[queue[0] / 10]; PORTB = digits[queue[1] / 10]; }
else
{
PORTC = 0b00001110;
PORTA = digits[queue[0] / 10]; }
_delay_ms(10);
if (qlen > 1)
{
PORTC = 0b00000101;
PORTA = digits[queue[0] % 10]; PORTB = digits[queue[1] % 10]; }
else
{
PORTC = 0b00001101;
PORTA = digits[queue[0] % 10]; }
_delay_ms(10);
}
}

int main()
{
initUART();

DDRA | = 0b01111111; // включение вывода для 1 дисплея
DDRB | = 0b01111111; // включение вывода для 2 дисплея
DDRC | = 0b00001111; // включение вывода для управляющих сигналов дисплеев
DDRD | = 0b00000110; // включение вывода на портах 2 (управление MAX485) и 1 (TX)
PORTD = 0b00000101; // включение подтягивающего резистора на порте 0 (RX) и режима отправки для MAX485

while(1)
{
goToMK2();
goToMK3();
outputQueue();
}
}

Листинг 2 – Код программы МК, принимающего сигналы от пользователей

#include <avr/io.h>

#include <avr/interrupt.h>

#include <util/delay.h>

volatile unsigned char counter = 0, // количество новых клиентов
send = 0; | // количество отправленных новых клиентов

void initUART(void) // инициализация UART
{
UBRRL=51; //скорость 9600 Бод при f=8 МГц
UCSRB=(1<<RXCIE)|(1<<RXEN)|(1<<TXEN); | //разрешение | прерывания | по | приему, | приема | и
передачи
UCSRC=(1<<URSEL)|(1<<UCSZ1)|(1<<UCSZ0); //8-битные посылки
}

void sendUart(unsigned char c) // отправка по UART
{
PORTD |= (1<<PD2); // включение передачи
UDR = c;
while(!(UCSRA&(1<<UDRE))) {}; // ожидание опустошения UDR while(!(UCSRA&(1<<TXC))) {}; // ожидание отправки PORTD &= ~(1<<PD2); // включение приема
}

ISR(USART_RXC_vect) // прерывание по приему по UART
{
unsigned char data = UDR;
if (data==0b10000000) // если полученные данные относятся к этому МК {
if (send < counter)
{
send++;
sendUart(send|0b10000000); // добавить пользователя в очередь }
else
sendUart(0b11111111); // не добавлять никого в очередь
}
}

void checkButton(unsigned char button_pin) // проверка нажатия на кнопку {
unsigned char i, j;
const unsigned char digits[] = { 0b00111111,
0b00000110,
0b01011011,
0b01001111,
0b01100110,
0b01101101,
0b01111101,
0b00000111,
0b01111111,
0b01101111 }; // соответствие цифр и их обозначения

на дисплее
if (!(PINB&button_pin)) // если кнопка нажата
{
counter++;
if (counter == 100) // если счетчик новых клиентов переполнился counter = 1;
for (j = 0; j < 3; j++) // вывод номера нового клиента
{
for (i = 0; i < 50; i++)
{
PORTB = 0b00000110;
PORTA = digits[counter / 10]; _delay_ms(10);
PORTB = 0b00000101;
PORTA = digits[counter % 10]; _delay_ms(10);
}
PORTB = 0b00000111;
_delay_ms(500);
}
}
}

int main()
{
sei(); // глобальное разрешение прерываний

initUART();
DDRA | = 0b01111111; // включение вывода для дисплея
DDRB | = 0b00000011; // включение вывода для управляющих сигналов дисплея
PORTB = 0b00000111; // включение подтягивающего резистора на порте 2 (кнопка) и выключение управляющих сигналов дисплея
DDRD = 0b00000110; // включение вывода на портах 2 (управление MAX485) и 1 (TX) PORTD = 0b00000001; // включение подтягивающего резистора на порте 0 (RX) и режима приема для MAX485

while(1)
checkButton(1<<PD2);
}

Листинг 3 – Код программы МК, принимающего сигналы от администратора

#include <avr/io.h>

#include <avr/interrupt.h>

#include <util/delay.h>

volatile char pressed = 0, | // флаг нажатия на кнопку
emptyQueue = 1; // флаг пустоты очереди

void initUART(void) // инициализация UART
{
UBRRL=51; //скорость 9600 Бод при f=8 МГц
UCSRB=(1<<RXCIE)|(1<<RXEN)|(1<<TXEN); | //разрешение | прерывания | по | приему, | приема | и
передачи
UCSRC=(1<<URSEL)|(1<<UCSZ1)|(1<<UCSZ0); //8-битные посылки
}

void sendUart(unsigned char c) // отправка по UART
{
PORTD |= (1<<PD2); // включение передачи
UDR = c;
while(!(UCSRA&(1<<UDRE))) {}; // ожидание опустошения UDR while(!(UCSRA&(1<<TXC))) {}; // ожидание отправки PORTD &= ~(1<<PD2); // включение приема
}

ISR(USART_RXC_vect) // прерывание по приему по UART {
unsigned char i, j, data = UDR;

const unsigned char digits[] = { 0b00111111, 0b00000110,
0b01011011,
0b01001111,
0b01100110,
0b01101101,
0b01111101,
0b00000111,
0b01111111,
0b01101111 }; // соответствие цифр и их обозначения на дисплее
if (!(data&0b10000000)) // если полученные данные относятся к этому МК {
if (data != 0b01111111)
emptyQueue = 0;
else
emptyQueue = 1;

if (data == 0b01111111 && pressed > 0) // если очередь пуста, но кнопка была нажата
{
sendUart(0);
pressed--;
}
else if (pressed > 0) // если кнопка была нажата {
sendUart(1);
pressed--;
for (j = 0; j < 3; j++) // вывод номера вызываемого пользователя {
for (i = 0; i < 50; i++)
{
PORTB = 0b00000110;
PORTA = digits[data / 10]; _delay_ms(10);
PORTB = 0b00000101;
PORTA = digits[data % 10]; _delay_ms(10);
}
PORTB = 0b00000111;
_delay_ms(500);
}
}
else
sendUart(0);
}
}

void checkButton(unsigned char button_pin) // проверка нажатия на кнопку {
if (!(PINB&button_pin))
{
while (!(PINB&button_pin)); pressed++;
}
}

void outputNotEmptyQueue(void) // вывод сигнала о том, что очередь не пуста {
PORTB = 0b00000110;
PORTA = 0b01000110;
_delay_ms(10);
PORTB = 0b00000101;
PORTA = 0b01110000;
_delay_ms(10);
PORTB = 0b00000111;
}

int main()
{
sei(); // глобальное разрешение прерываний

initUART();
DDRA | = 0b01111111; // включение вывода для дисплея
DDRB | = 0b00000011; // включение вывода для управляющих сигналов дисплея
PORTB = 0b00000111; // включение подтягивающего резистора на порте 2 (кнопка) и выключение управляющих сигналов дисплея
DDRD = 0b00000110; // включение вывода на портах 2 (управление MAX485) и 1 (TX) PORTD = 0b00000001; // включение подтягивающего резистора на порте 0 (RX) и режима приема для MAX485

while(1)
{
checkButton(1<<PD2);
if (emptyQueue == 0)
| outputNotEmptyQueue();
}
}
