mzotof/KR_MPS/Зотов Титул РПЗ + задание.pdf

2021 г.

Министерство науки и высшего образования Российской Федерации Федеральное государственное бюджетное образовательное учреждение высшего образования
«Московский государственный технический университет имени Н.Э. Баумана
(национальный исследовательский университет)» (МГТУ им. Н.Э. Баумана)

ФАКУЛЬТЕТ ИНФОРМАТИКА И СИСТЕМЫ УПРАВЛЕНИЯ

КАФЕДРА КОМПЬЮТЕРНЫЕ СИСТЕМЫ И СЕТИ (ИУ6)

НАПРАВЛЕНИЕ ПОДГОТОВКИ 09.03.01 Информатика и вычислительная техника

# РАСЧЕТНО-ПОЯСНИТЕЛЬНАЯ ЗАПИСКА

# К КУРСОВОЙ РАБОТЕ

# по дисциплине «Микропроцессорные системы»

# НА ТЕМУ:

# ___Аппаратная система «Электронная очередь»___

Студент | ИУ6-73Б | М.А. Зотов
(Группа) | (Подпись, дата) | (И.О. Фамилия)
Руководитель | С.В. Ибрагимов
(Подпись, дата) | (И.О. Фамилия)

Министерство науки и высшего образования Российской Федерации Федеральное государственное бюджетное образовательное учреждение высшего образования
«Московский государственный технический университет имени Н.Э. Баумана (национальный исследовательский университет)» (МГТУ им. Н.Э. Баумана)

УТВЕРЖДАЮ

Заведующий кафедрой ___ИУ6___

______________ А.В. Пролетарский « _1_ » _сентября_ 2021 г.

## З А Д А Н И Е

## на выполнение курсовой работы

по дисциплине _Микропроцессорные системы_

Студент группы _ИУ6-73Б_

_________________________________Зотов Макар Алексеевич_________________________ (Фамилия, имя, отчество)

Тема курсовой работы __Аппаратная система «Электронная очередь»___________________

Направленность КР (учебная, исследовательская, практическая, производственная, др.) _учебная________________________________________________________________________ Источник тематики (кафедра, предприятие, НИР) _кафедра_____________________________

График выполнения работы: 25% к 4 нед., 50% к 7 нед., 75% к 11 нед., 100% к 14 нед.

Задание: Разработать аппаратную систему «Электронная очередь», осуществляющую контроль очереди пользователей. Устройство должно представлять из себя сеть из трех устройств на основе микроконтроллеров AVR, связанных между собой с помощью интерфейса по стандарту RS-485: первое устройство должно осуществлять прием сигналов от пользователей об их желании встать в очередь, второе должно выводить на дисплей состояние очереди, а третье должно принимать от администратора сигналы о том, что первый пользователь в очереди может проходить._____________________________________ Разработать схемы, алгоритмы и программы. Отладить разработанную программу и проверить ее работу с помощью симулятора._________________________________________ Оценить потребляемую мощность устройства._____________________ __________________

Оформление курсовой работы:
1. Расчетно-пояснительная записка на 30-40 листах формата А4.
2. Перечень графического материала курсовой работы:
а) функциональная электрическая схема;
б) принципиальная электрическая схема.

Дата выдачи задания « 01 » сентября 2021 г.

Руководитель | 01.09.2021 | С.В. Ибрагимов
| (Подпись, дата) | (И.О. Фамилия)
Студент | 01.09.2021 | М.А. Зотов
| (Подпись, дата) | (И.О. Фамилия)
