mzotof/KR_MPS/Перечень1.JPG

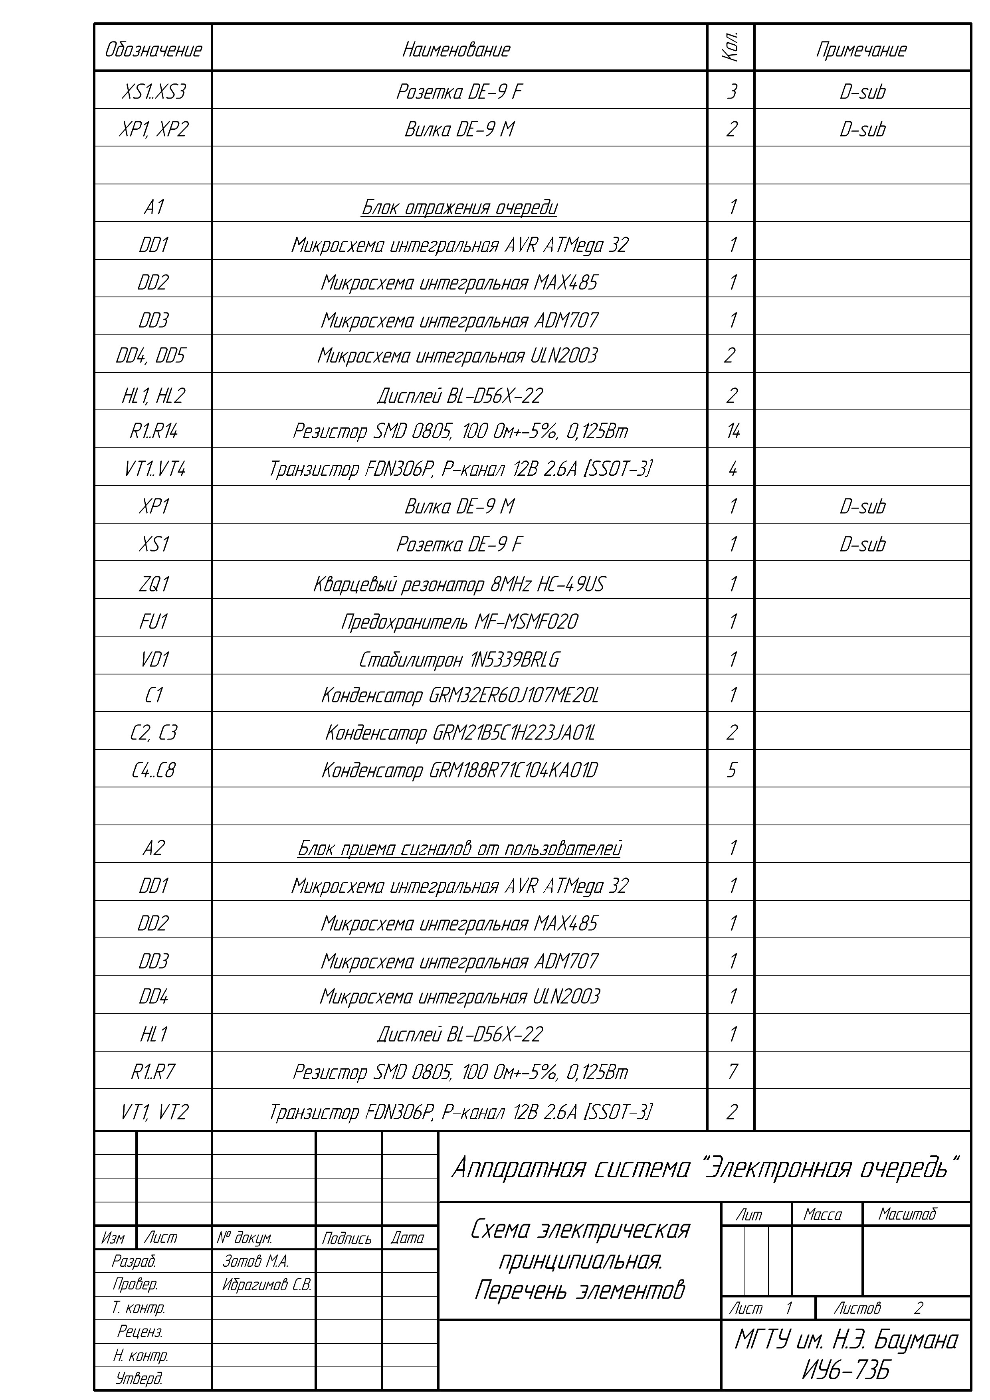
Перечень1.JPG
