mzotof/KR_MPS/Перечень2.JPG

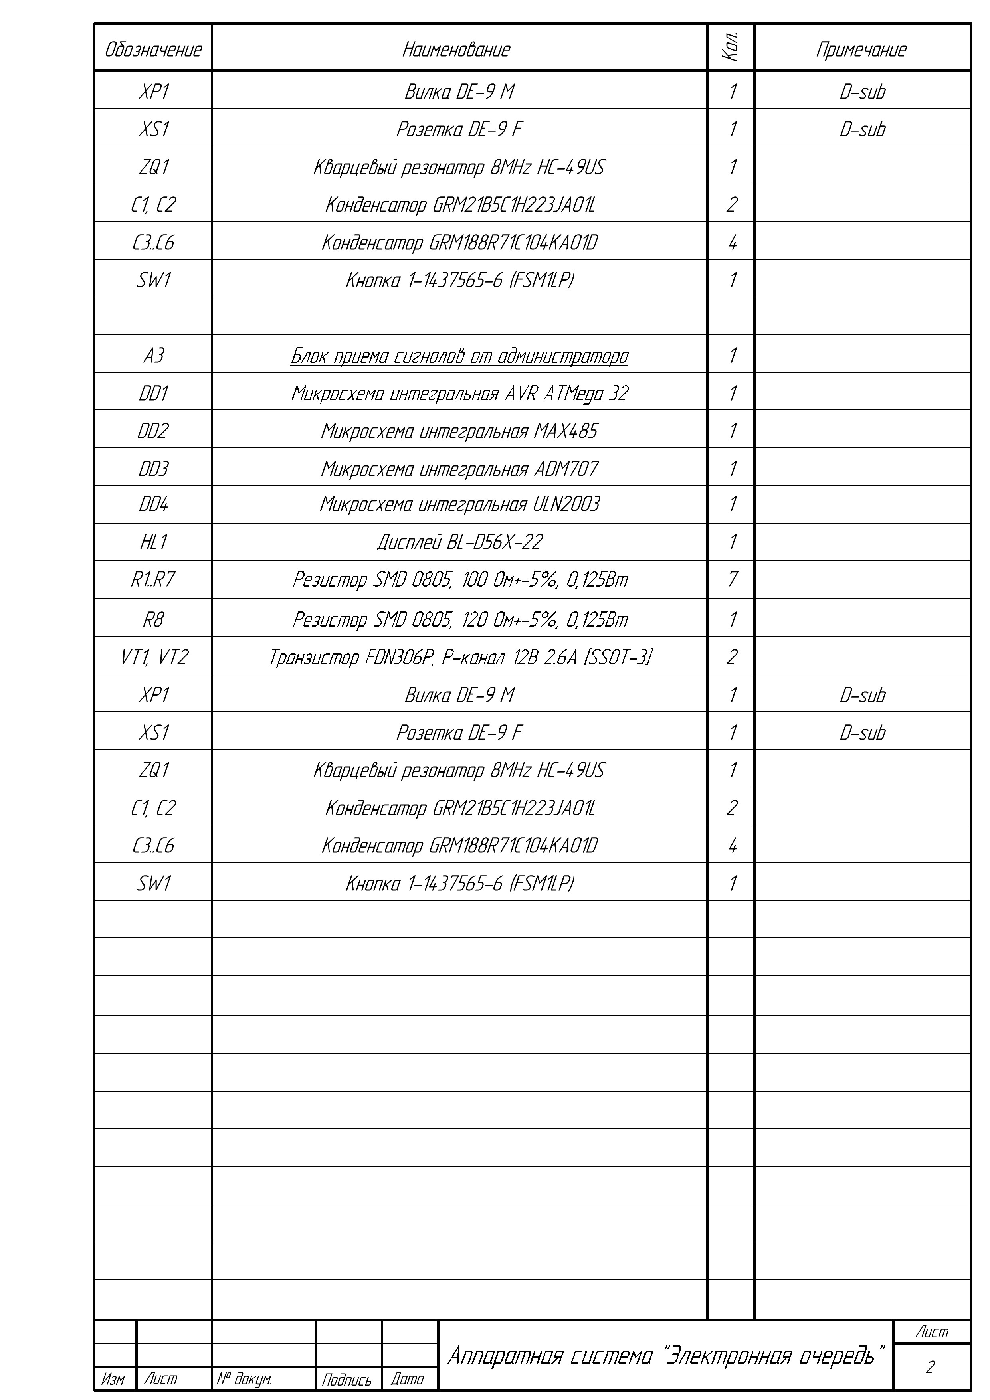
Перечень2.JPG
