mzotof/KR_MPS/Принципиальная схема.JPG

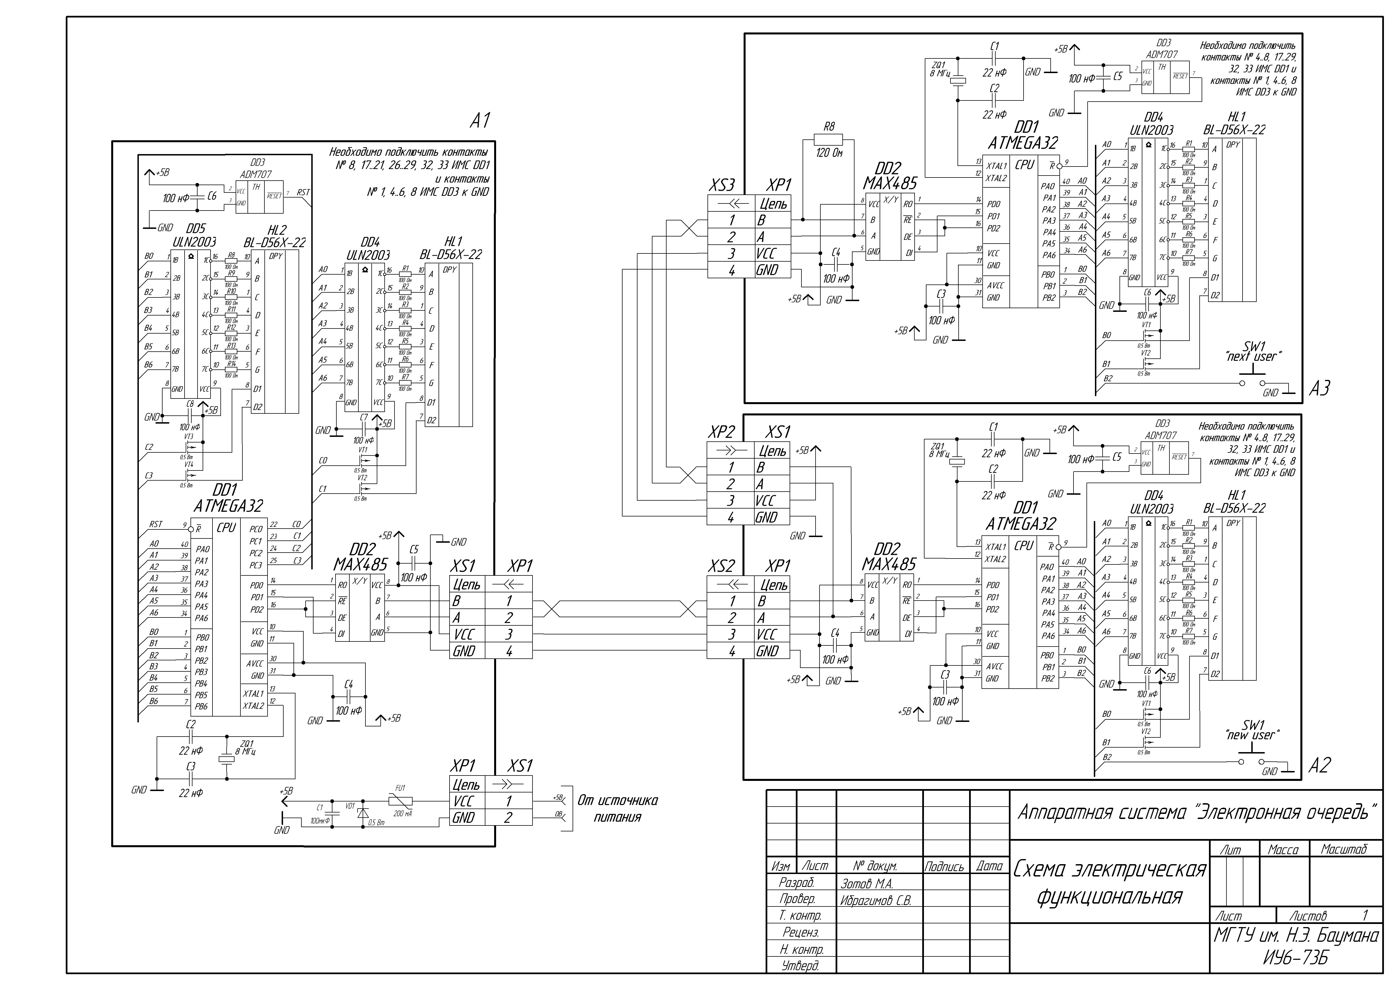
Принципиальная схема.JPG
