mzotof/KR_MPS/Функциональная схема.JPG

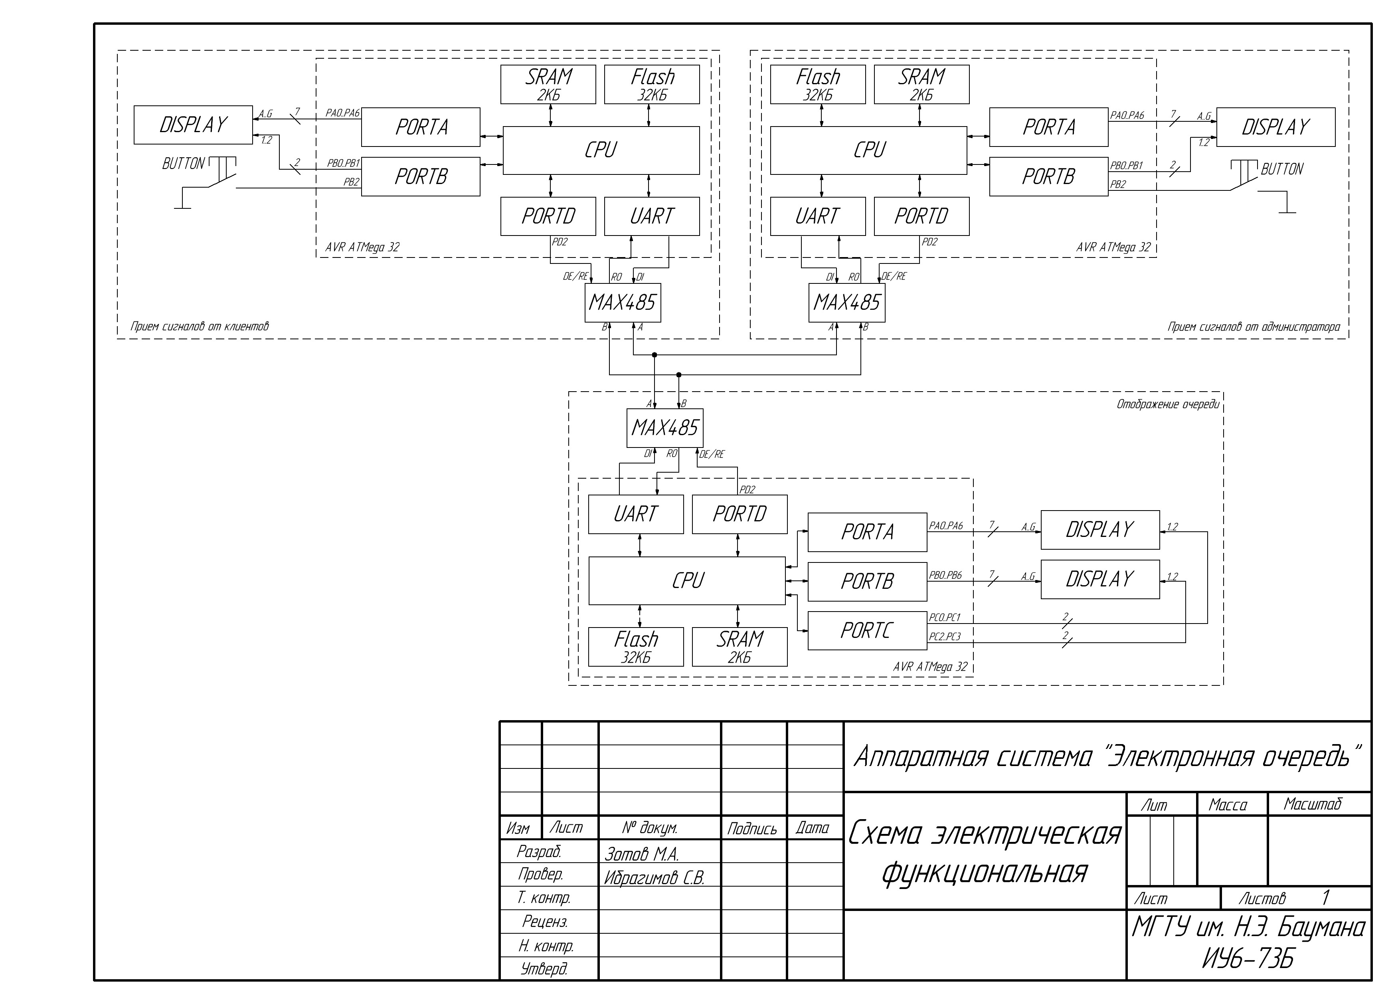
Функциональная схема.JPG
