mzotof/KR_MPS/(list of files, drawings)

Other design files:
KR.pdsprj
