mzotof/KR_MPS/(commit log)

2021-11-16 Первый коммит
    [KR.pdsprj]
2021-11-16 Поменял концепцию работы с slave_admin
    [KR.pdsprj]
2021-11-17 После консультации
    [KR.pdsprj]
2021-11-21 Финальная версия проекта
    [KR.pdsprj]
2021-11-21 Функциональная схема v1.0
2021-11-23 Принципиальная v1.0
2021-11-29 Функциональная v2.0
    [KR.pdsprj]
2021-12-02 Исправления функ. и принцип. схем
2021-12-09 Обновил функциональную и принципиальную схемы
2021-12-09 Перечень+принципиальная
2021-12-09 Функциональная
2021-12-23 Исправления РПЗ, принцип. схемы и перечня
2021-12-25 Минорные правки
